JoppeJoppinger/Inkterface_GabeEdition/design/breakout-board.png

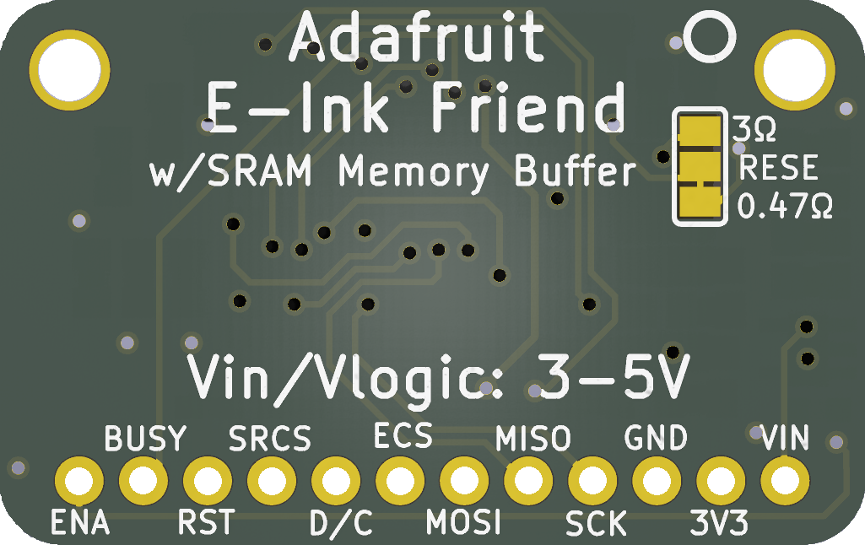
design/breakout-board.png
