JoppeJoppinger/Inkterface_GabeEdition/design/feather-board.png

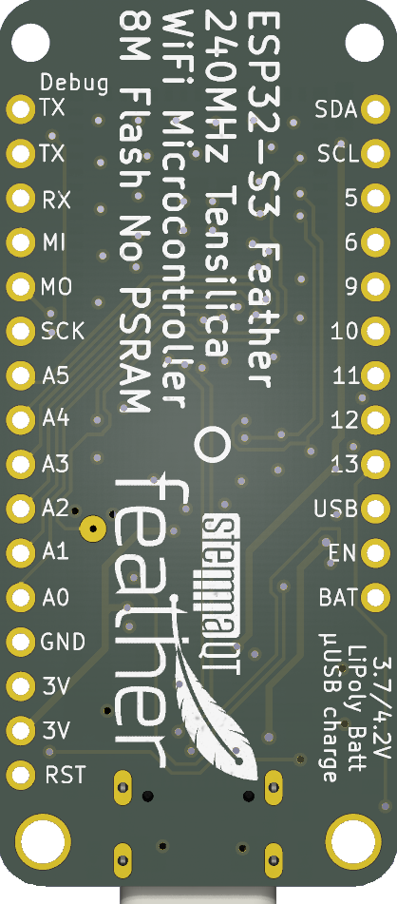
design/feather-board.png
