JoppeJoppinger/Inkterface_GabeEdition/design/store-assets/Header_Capsule.png

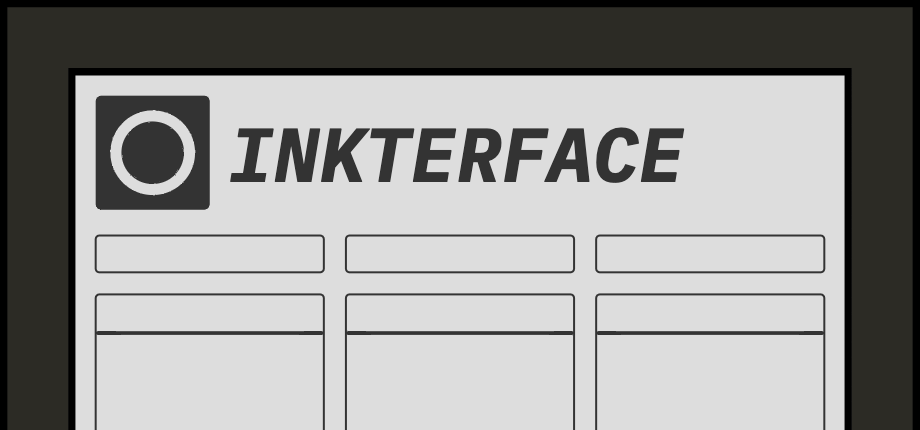
design/store-assets/Header_Capsule.png
