JoppeJoppinger/Inkterface_GabeEdition/design/store-assets/Library_Capsule.png

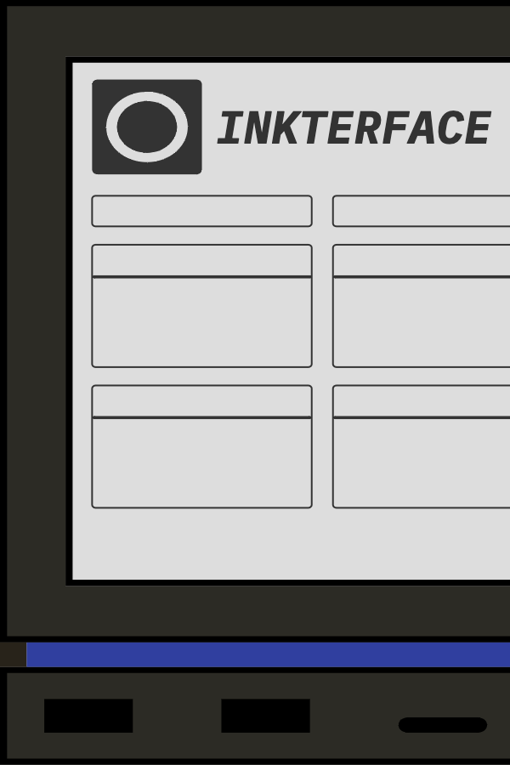
design/store-assets/Library_Capsule.png
