JoppeJoppinger/Inkterface_GabeEdition/design/store-assets/Library_Header.png

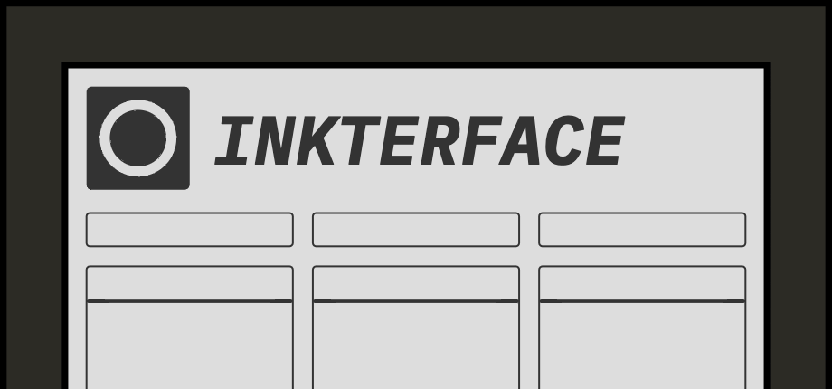
design/store-assets/Library_Header.png
