JoppeJoppinger/Inkterface_GabeEdition/design/store-assets/Library_Hero.png

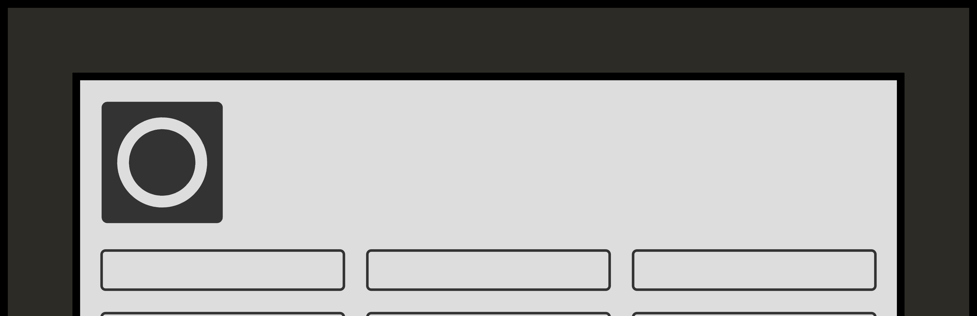
design/store-assets/Library_Hero.png
