JoppeJoppinger/Inkterface_GabeEdition/design/store-assets/Machine_Status.png

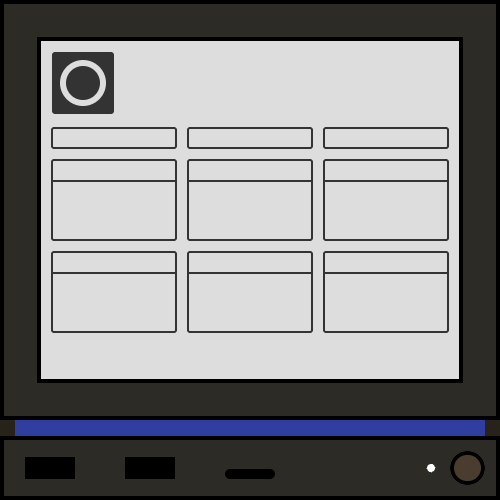
design/store-assets/Machine_Status.png
