JoppeJoppinger/Inkterface_GabeEdition/design/store-assets/Main_Capsule.png

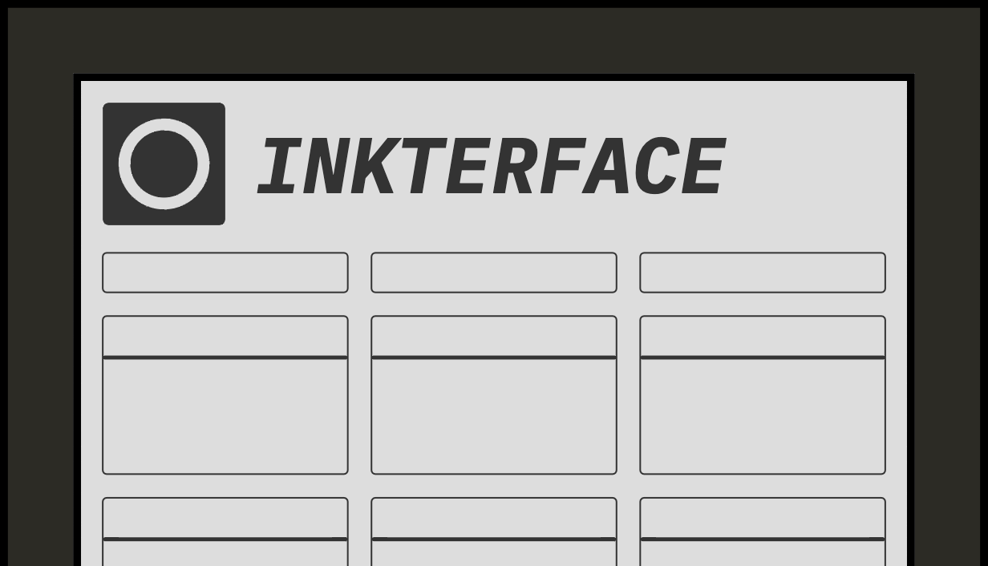
design/store-assets/Main_Capsule.png
