JoppeJoppinger/Inkterface_GabeEdition/design/store-assets/Small_Capsule.png

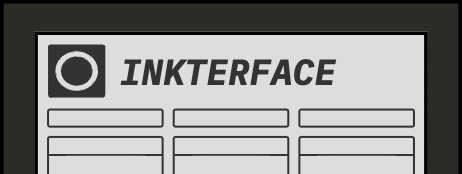
design/store-assets/Small_Capsule.png
