JoppeJoppinger/Inkterface_GabeEdition/docs/eInk Feather Friend Schematic.png

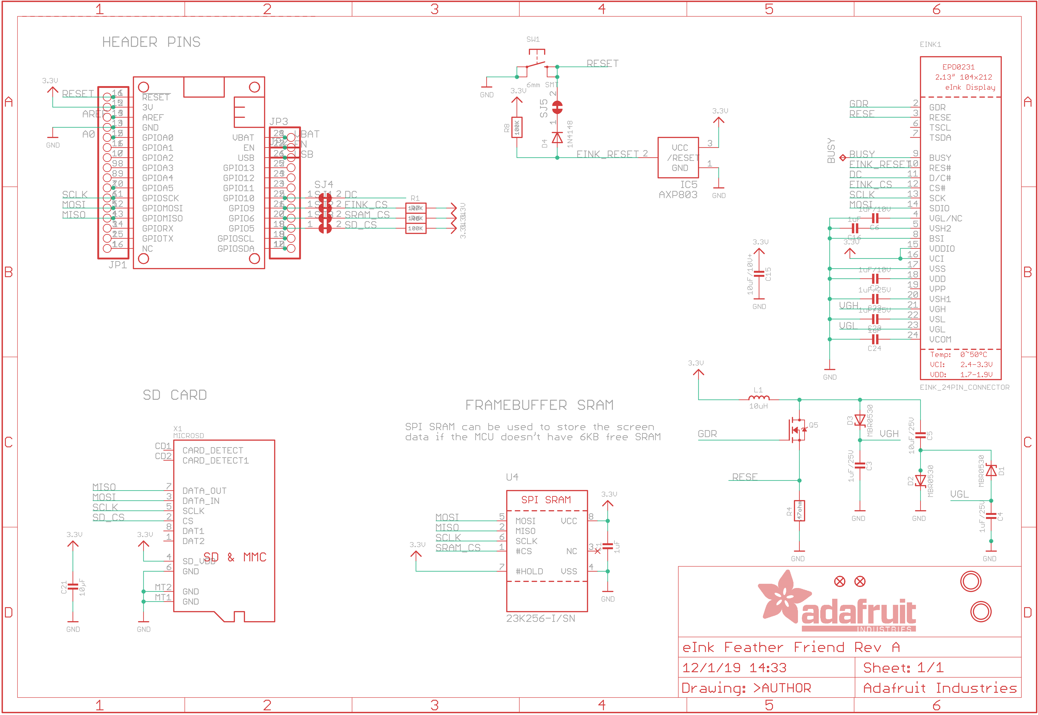
docs/eInk Feather Friend Schematic.png
