JoppeJoppinger/Inkterface_GabeEdition/resources/gabe_cube_original.png

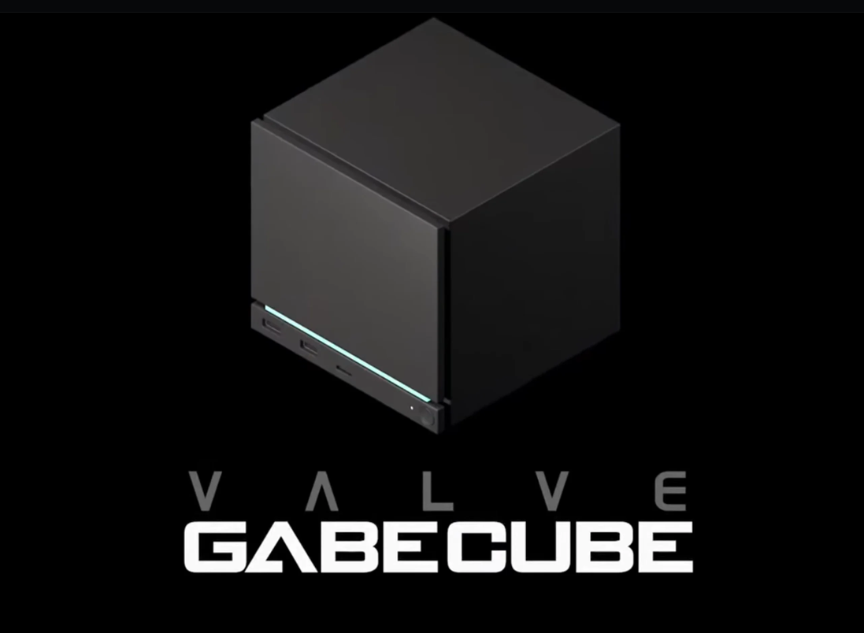
resources/gabe_cube_original.png
