JoppeJoppinger/Inkterface_GabeEdition/resources/gaben.png

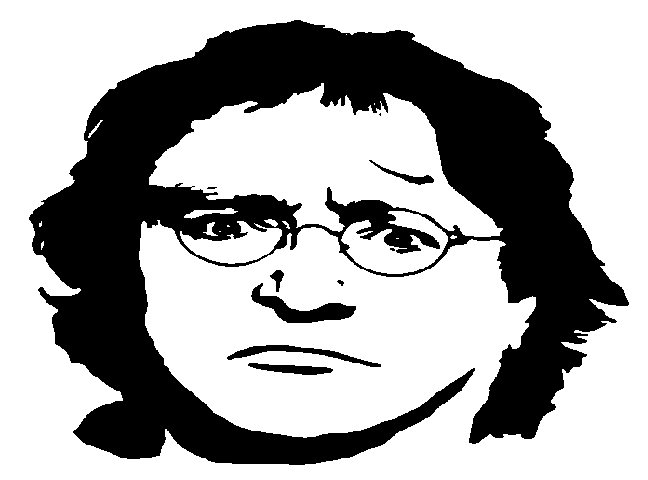
resources/gaben.png
