JoppeJoppinger/Inkterface_GabeEdition/cad/Inkterface - Print Plate.step

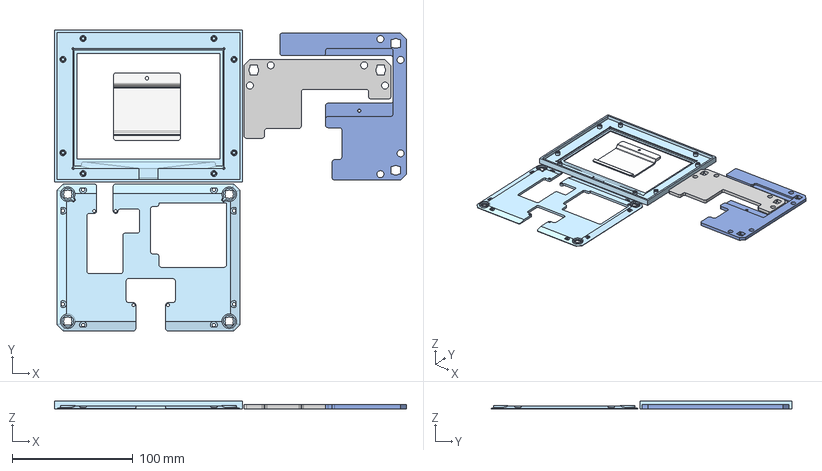
[picture p23: CAD file, 2026-10-14]
cad/Inkterface - Print Plate.step
292.1 x 249.6 x 6.50 mm
Faceplate
Battery Retainer
Board Plate
Midplate Left
Midplate Right
