JoppeJoppinger/Inkterface_GabeEdition/cad/Inkterface - Board Plate.step

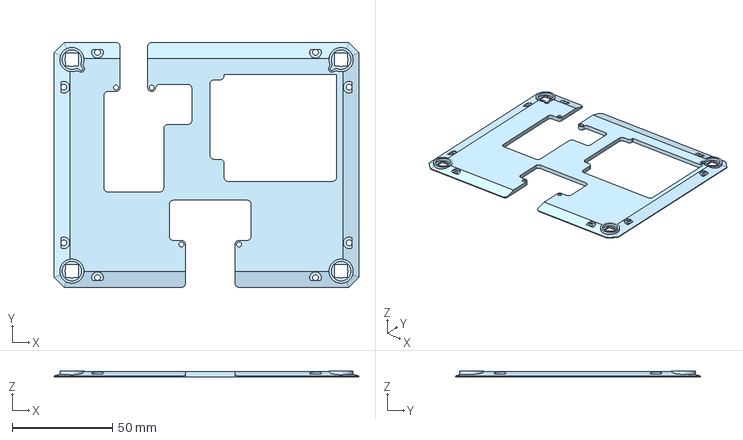
[picture p24: CAD file, 2026-10-14]
cad/Inkterface - Board Plate.step
151.8 x 121.9 x 2.81 mm
