JoppeJoppinger/Inkterface_GabeEdition/cad/Inkterface - Midplate Left.step

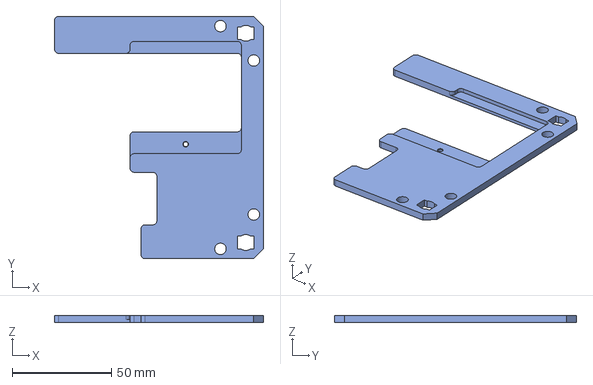
[picture p25: CAD file, 2026-10-14]
cad/Inkterface - Midplate Left.step
105.2 x 121.9 x 3.56 mm
