JoppeJoppinger/Inkterface_GabeEdition/cad/Inkterface - Midplate Right.step

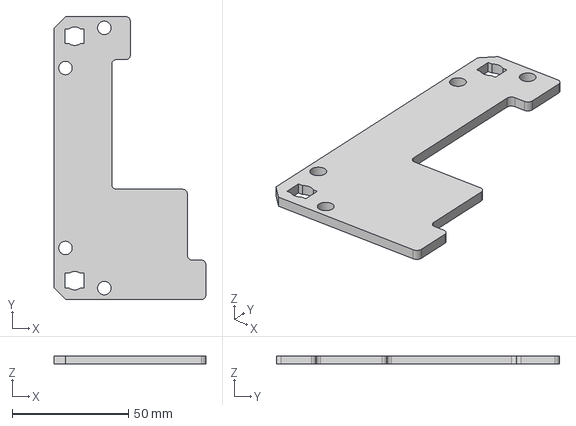
[picture p26: CAD file, 2026-10-14]
cad/Inkterface - Midplate Right.step
65.4 x 121.9 x 3.56 mm
