JoppeJoppinger/Inkterface_GabeEdition/cad/Inkterface - Faceplate.step

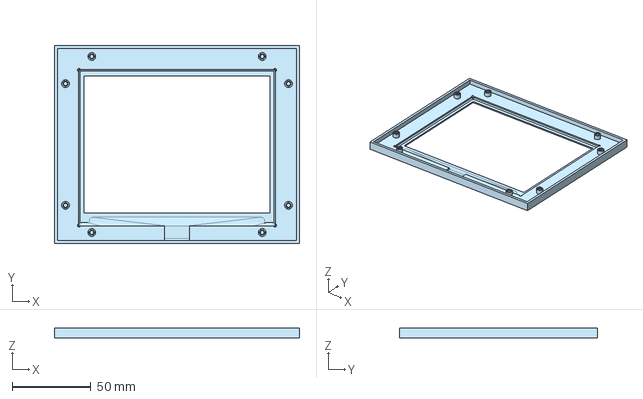
[picture p27: CAD file, 2026-10-14]
cad/Inkterface - Faceplate.step
156.0 x 126.1 x 6.50 mm
