JoppeJoppinger/Inkterface_GabeEdition/cad/Inkterface - Battery Retainer.step

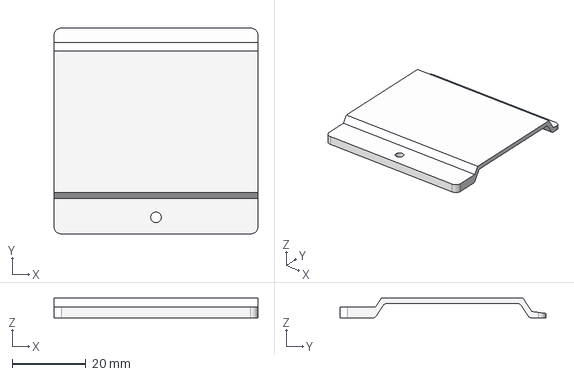
[picture p28: CAD file, 2026-10-14]
cad/Inkterface - Battery Retainer.step
55.5 x 56.0 x 5.44 mm
