JoppeJoppinger/Inkterface_GabeEdition/(list of files, cad)

Other CAD files:
cad/Inkterface - Battery Retainer.stl
cad/Inkterface - Board Plate.stl
cad/Inkterface - Faceplate.stl
cad/Inkterface - Midplate Left.stl
cad/Inkterface - Midplate Right.stl
cad/Inkterface - Print Plate.stl
