JoppeJoppinger/Inkterface_GabeEdition/docs/Inkterface Setup.pdf

### Inkterface Setup

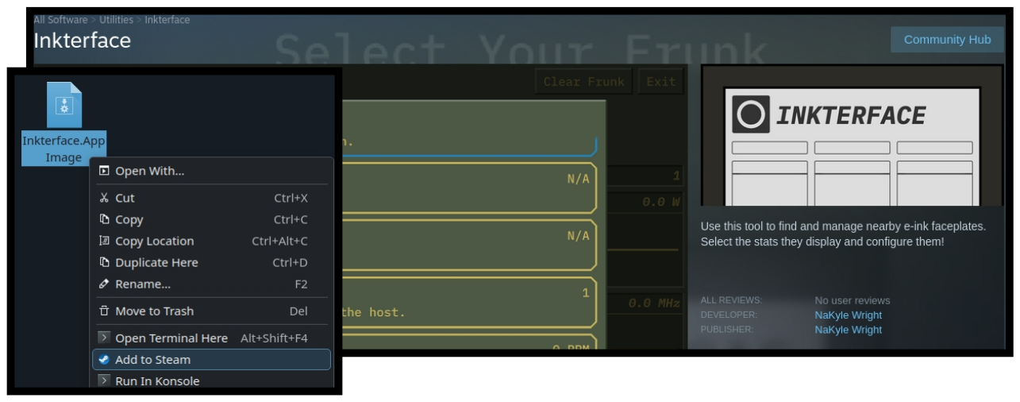
[picture p39: figure]

Install Application:
You can add the AppImage to Steam or install it once it's available on the store!

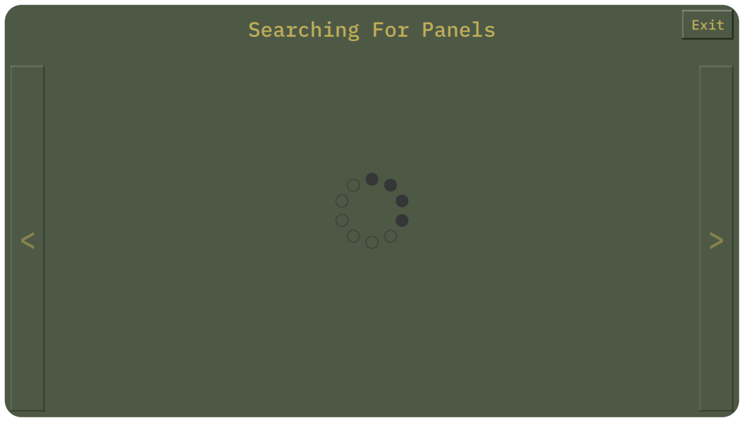
[picture p40: figure]

Discover Nearby Panels:
Make sure you have bluetooth enabled and that the panel is nearby.

If it doesn't appear try pressing the reset button on the back.

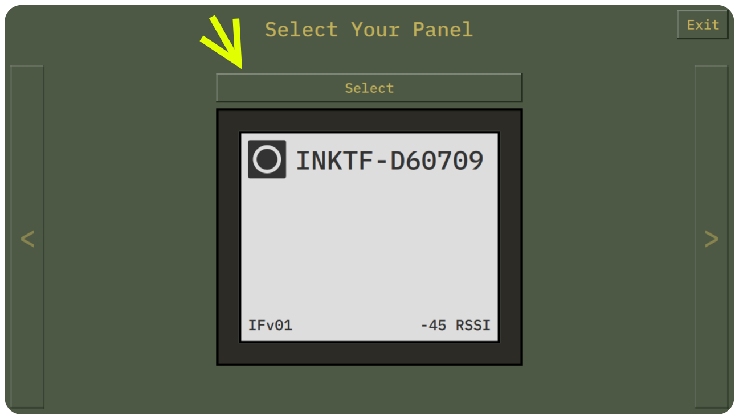
[picture p41: figure]

Select Your Panel:
Panels will show up on this as a list, sorted by RSSI, and with unsupported inkterfaceversions at the back.

Compare the name on your panel to the name shown on the result, then click Select.

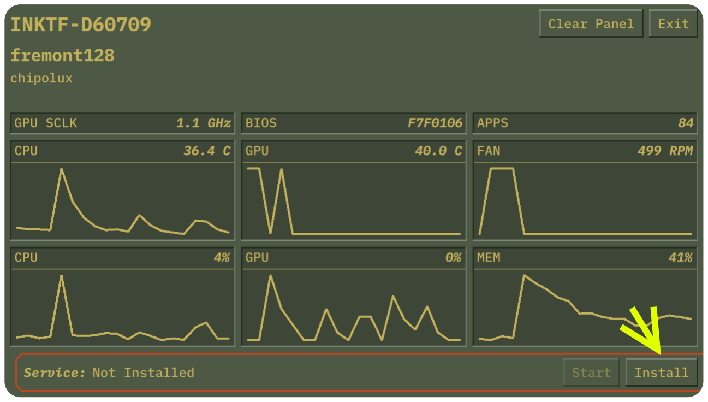
[picture p42: figure]

Install Service:
Once a panel is selected you will be taken to the configuration page.

Install the service that will run in the background to collect stats and transmit them to the Inkterface.

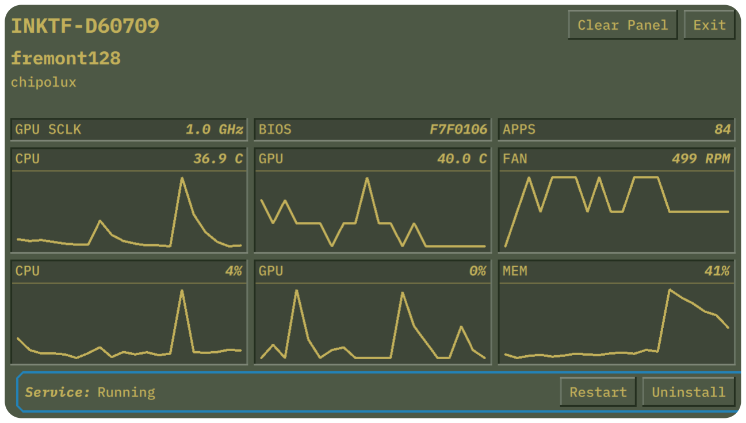
[picture p43: figure]

Configure What Inkterface Shows:
By clicking on any of the readouts you can adjust what is shown.

Changes take place on the next update cycle.

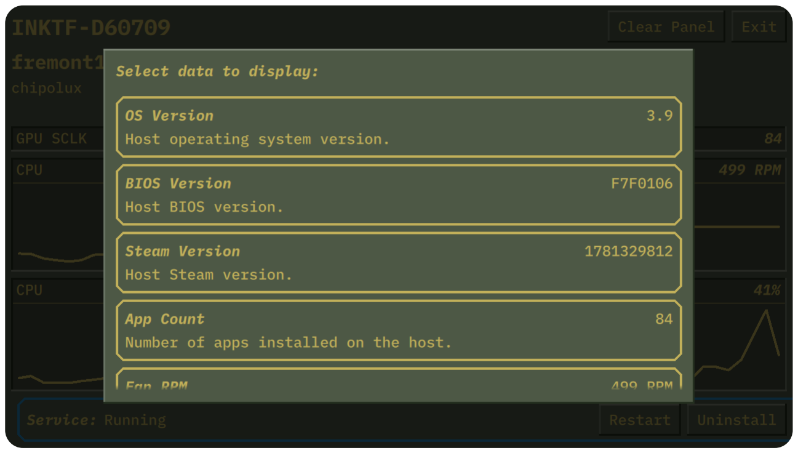
[picture p44: figure]

You're done! You can close the app, the service will maintain the connection automatically.

If you have issues try re-installing Inkterface, re-installing the service, and resetting your Inkterface!
