JoppeJoppinger/Inkterface_GabeEdition/boards/Adafruit eInk Feather Friend/Adafruit eInk Feather Friend.kicad_pcb

## KiCad design boards/Adafruit eInk Feather Friend/Adafruit eInk Feather Friend.kicad_pcb (2026-10-14)

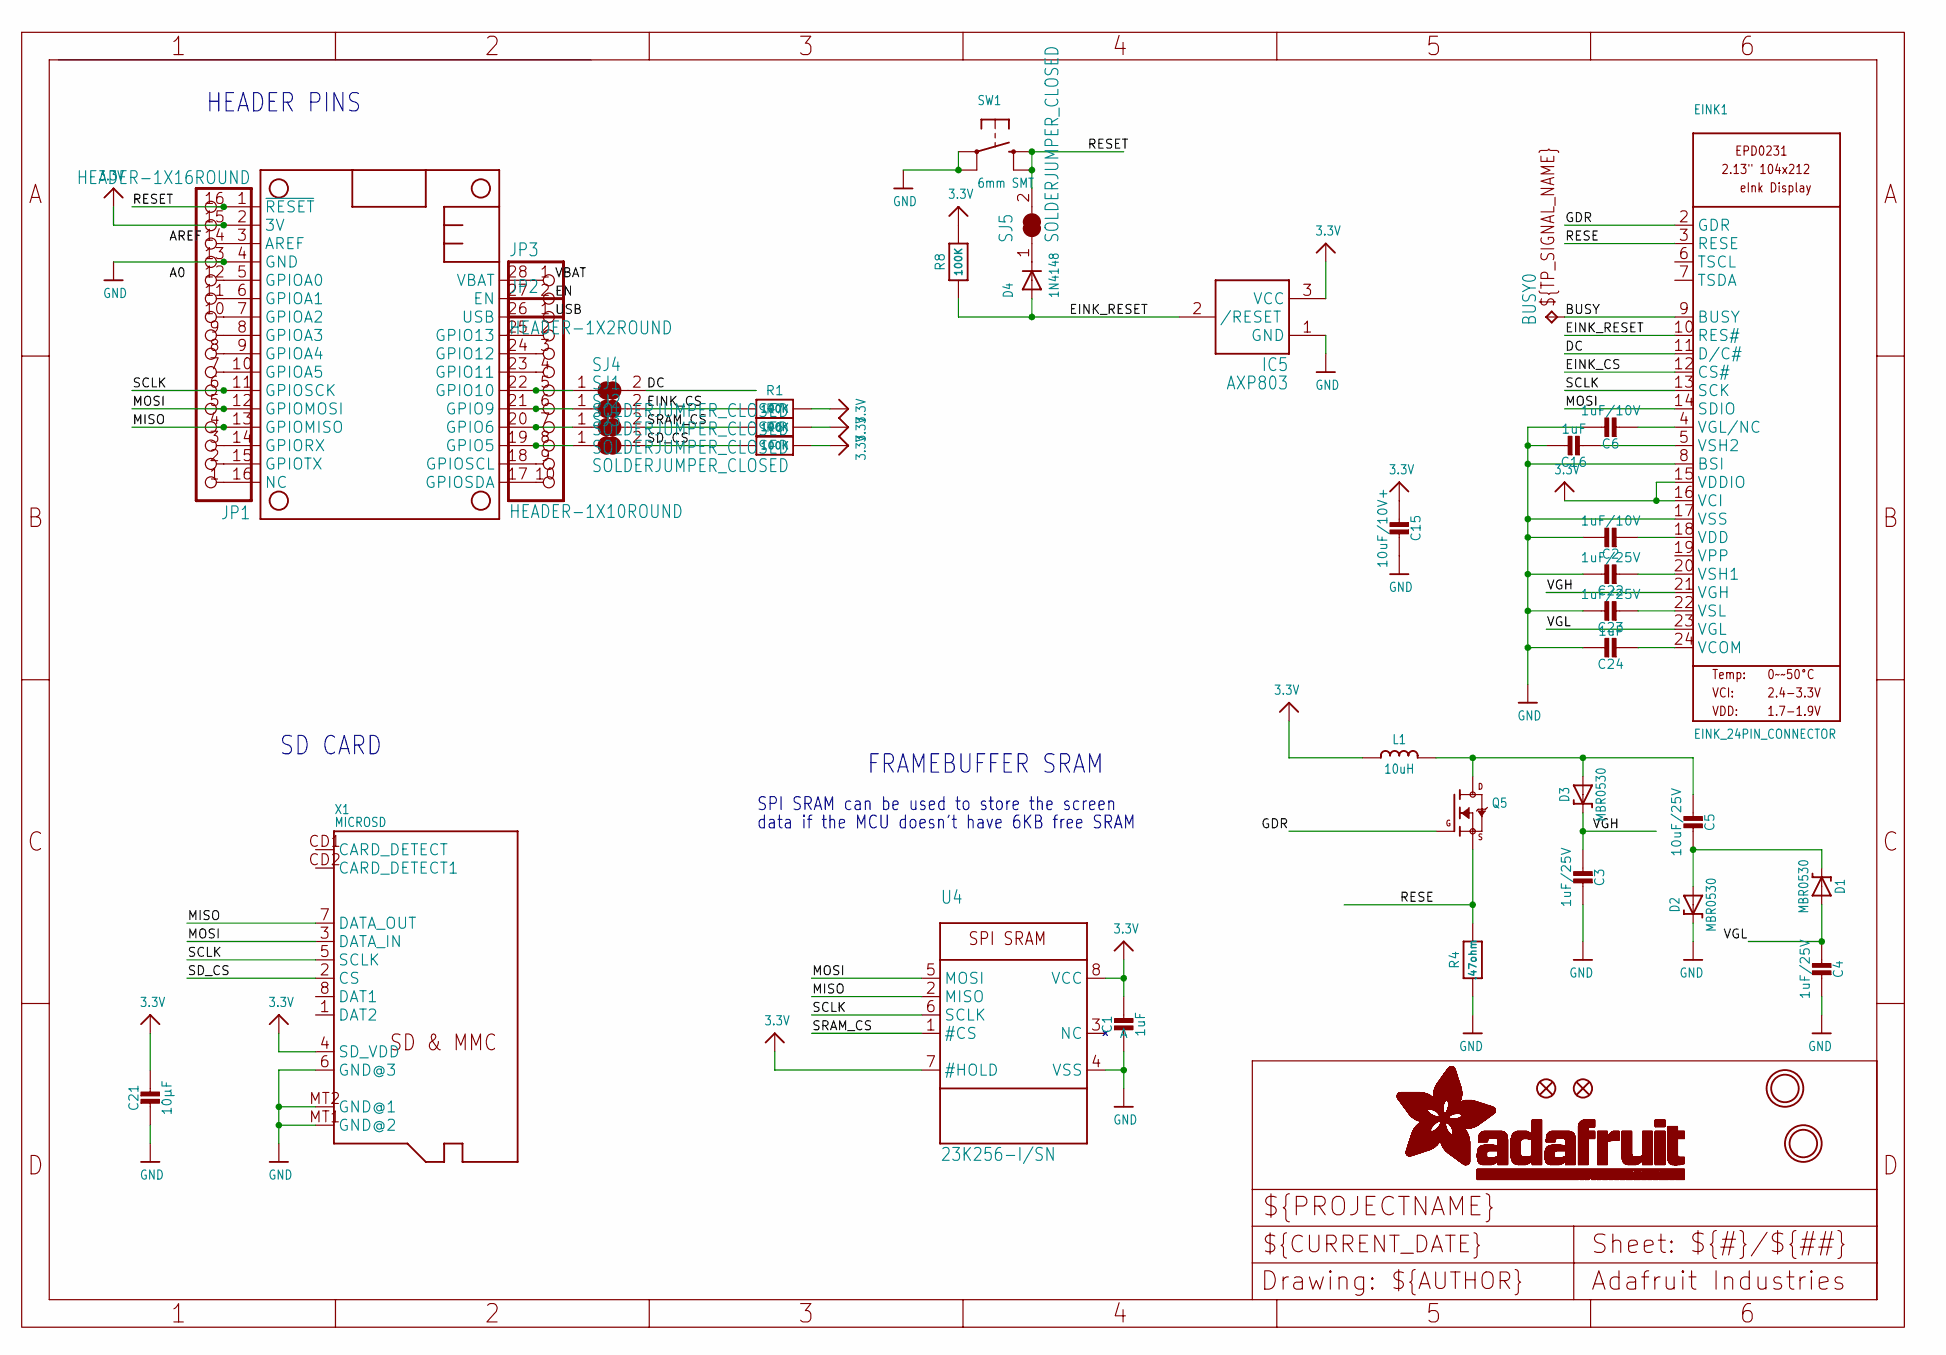
[picture p53: schematic Adafruit eInk Feather Friend.kicad_sch]

Parts:
BUSY0: TPTP15SQ; TP15SQ
C1: 1uF; 0805_10MGAP
C2, C6: 1uF/10V; 0805-NO
C3, C4, C22, C23: 1uF/25V; 0805-NO
C5: 10uF/25V; 0805-NO
C15: 10uF/10V+; 0805-NO
C16, C24: 1uF; 0805-NO
C21: 10µF; 0805-NO
D1, D2, D3: MBR0530; SOD-123
D4: 1N4148; SOD-323F
EINK1: EINK_24PIN_CONNECTOR; EINK_24PIN
FID1, FID3: FIDUCIAL_1MM
IC5: AXP803; SOT23
JP1: HEADER-1X16ROUND; 1X16_ROUND
JP2: HEADER-1X10ROUND; 1X10_ROUND
JP3: HEADER-1X2ROUND; 1X02_ROUND
L1: 10uH; INDUCTOR_4X4MM_NR401
MS1: FEATHERWING_NOHOLES
Q5: IRLML0100; SOT23-3
R1, R6, R7, R8: 100K; 0603-NO
R4: .47ohm; 0805_10MGAP
SJ1, SJ2, SJ3, SJ4, SJ5: SOLDERJUMPER_CLOSED; SOLDERJUMPER_CLOSEDWIRE
SW1: 6mm SMT; BTN_KMR2_4.6X2.8
U4: 23K256-I/SN; SOIC8_150MIL
U$3, U$4: MOUNTINGHOLE2.5; MOUNTINGHOLE_2.5_PLATED
X1: MICROSD

Connections:
3.3V: C1.1, C15.2, C21.1, EINK1.15 (VDDIO), EINK1.16 (VCI), IC5.3 (VCC), JP1.15, L1.P$2 (2), MS1.2 (3V), R1.2, R6.2, R7.2, R8.2, U4.7 (#HOLD), U4.8 (VCC), X1.4 (SD_VDD)
A0: JP1.12, MS1.5 (GPIOA0)
AREF: JP1.14, MS1.3 (AREF)
BUSY: BUSY0.TP, EINK1.9 (BUSY)
DC: EINK1.11 (D/C#), SJ4.2
EINK_CS: EINK1.12 (CS#), R1.1, SJ1.2
EINK_RESET: D4.A, EINK1.10 (RES#), IC5.2 (/RESET), R8.1
EN: JP3.2, MS1.27 (EN)
GDR: EINK1.2 (GDR), Q5.1 (G)
GND: C1.2, C2.1, C3.2, C4.2, C6.1, C15.1, C16.1, C21.2, C22.1, C23.1, C24.1, D2.C, EINK1.8 (BSI), EINK1.17 (VSS), IC5.1 (GND), JP1.13, MS1.4 (GND), R4.2, SW1.A, SW1.A' (P1), U4.4 (VSS), X1.6 (GND@3), X1.MT1 (GND@2), X1.MT2 (GND@1)
H: JP2.8, MS1.19 (GPIO5), SJ3.1
I: JP2.7, MS1.20 (GPIO6), SJ2.1
J: JP2.6, MS1.21 (GPIO9), SJ1.1
K: JP2.5, MS1.22 (GPIO10), SJ4.1
MISO: JP1.4, MS1.13 (GPIOMISO), U4.2 (MISO), X1.7 (DATA_OUT)
MOSI: EINK1.14 (SDIO), JP1.5, MS1.12 (GPIOMOSI), U4.5 (MOSI), X1.3 (DATA_IN)
unnamed: JP1.7, MS1.10 (GPIOA5)
unnamed: C5.2, D1.C, D2.A
unnamed: C5.1, D3.A, L1.P$1 (1), Q5.3 (D)
unnamed: C16.2, EINK1.5 (VSH2)
unnamed: C2.2, EINK1.18 (VDD)
unnamed: C22.2, EINK1.20 (VSH1)
unnamed: D4.C, SJ5.1
unnamed: JP1.11, MS1.6 (GPIOA1)
unnamed: C6.2, EINK1.4 (VGL/NC)
unnamed: JP1.10, MS1.7 (GPIOA2)
unnamed: JP1.9, MS1.8 (GPIOA3)
unnamed: JP1.8, MS1.9 (GPIOA4)
unnamed: JP1.3, MS1.14 (GPIORX)
unnamed: JP1.2, MS1.15 (GPIOTX)
unnamed: JP1.1, MS1.16 (NC)
unnamed: JP2.10, MS1.17 (GPIOSDA)
unnamed: JP2.9, MS1.18 (GPIOSCL)
unnamed: JP2.4, MS1.23 (GPIO11)
unnamed: JP2.3, MS1.24 (GPIO12)
unnamed: JP2.2, MS1.25 (GPIO13)
unnamed: C23.2, EINK1.22 (VSL)
unnamed: C24.2, EINK1.24 (VCOM)
RESE: EINK1.3 (RESE), Q5.2 (S), R4.1
RESET: JP1.16, MS1.1 (~RESET), SJ5.2, SW1.B (S), SW1.B' (S1)
SCLK: EINK1.13 (SCK), JP1.6, MS1.11 (GPIOSCK), U4.6 (SCLK), X1.5 (SCLK)
SD_CS: R6.1, SJ3.2, X1.2 (CS)
SRAM_CS: R7.1, SJ2.2, U4.1 (#CS)
USB: JP2.1, MS1.26 (USB)
VBAT: JP3.1, MS1.28 (VBAT)
VGH: C3.1, D3.C, EINK1.21 (VGH)
VGL: C4.1, D1.A, EINK1.23 (VGL)

Notes on the sheet:
FRAMEBUFFER SRAM
SPI SRAM can be used to store the screen
HEADER PINS
data if the MCU doesn't have 6KB free SRAM
SD CARD

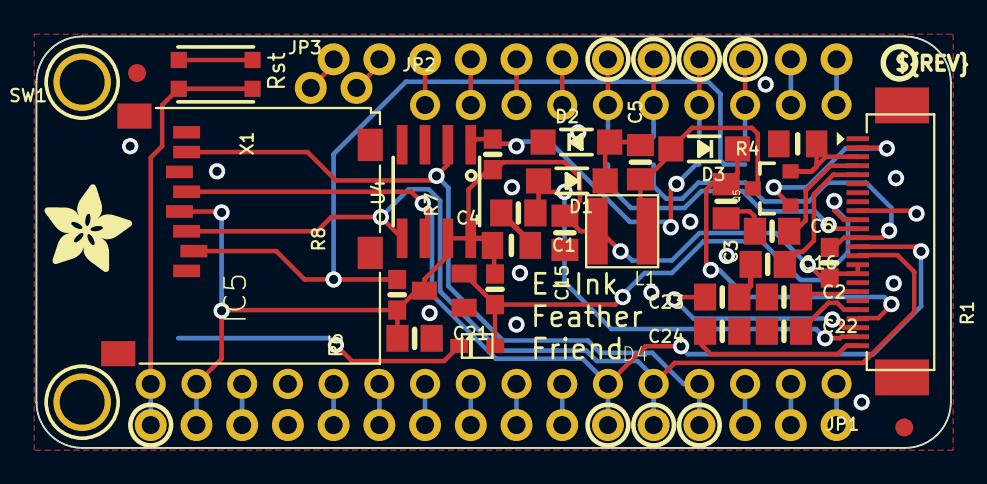
[picture p54: board Adafruit eInk Feather Friend.kicad_pcb from above]

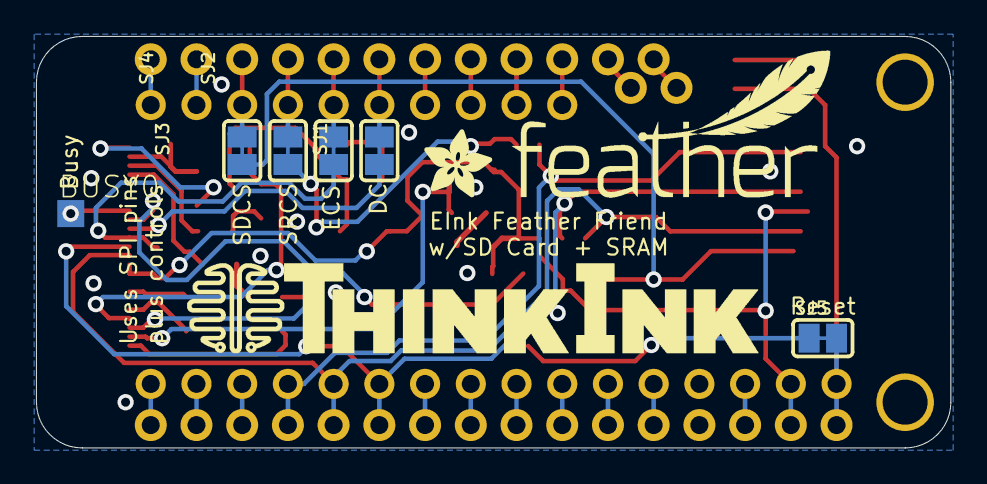
[picture p55: board Adafruit eInk Feather Friend.kicad_pcb from below]

Board: 2 copper layers, 50.8 x 22.9 mm, 47 parts (9 on the bottom side), 47 nets.

Other parts of the board:
U$5: THINKINK_1.25IN
U$6: FEATHERLOGO_MED
U$8: ADAFRUIT_5MM
U$9: PCBFEAT-REV-040
U$17: ADAFRUIT_3.5MM
