JoppeJoppinger/Inkterface_GabeEdition/boards/originals/Adafruit eInk Breakout Friend.brd

## EAGLE design boards/originals/Adafruit eInk Breakout Friend.brd (2026-10-14)

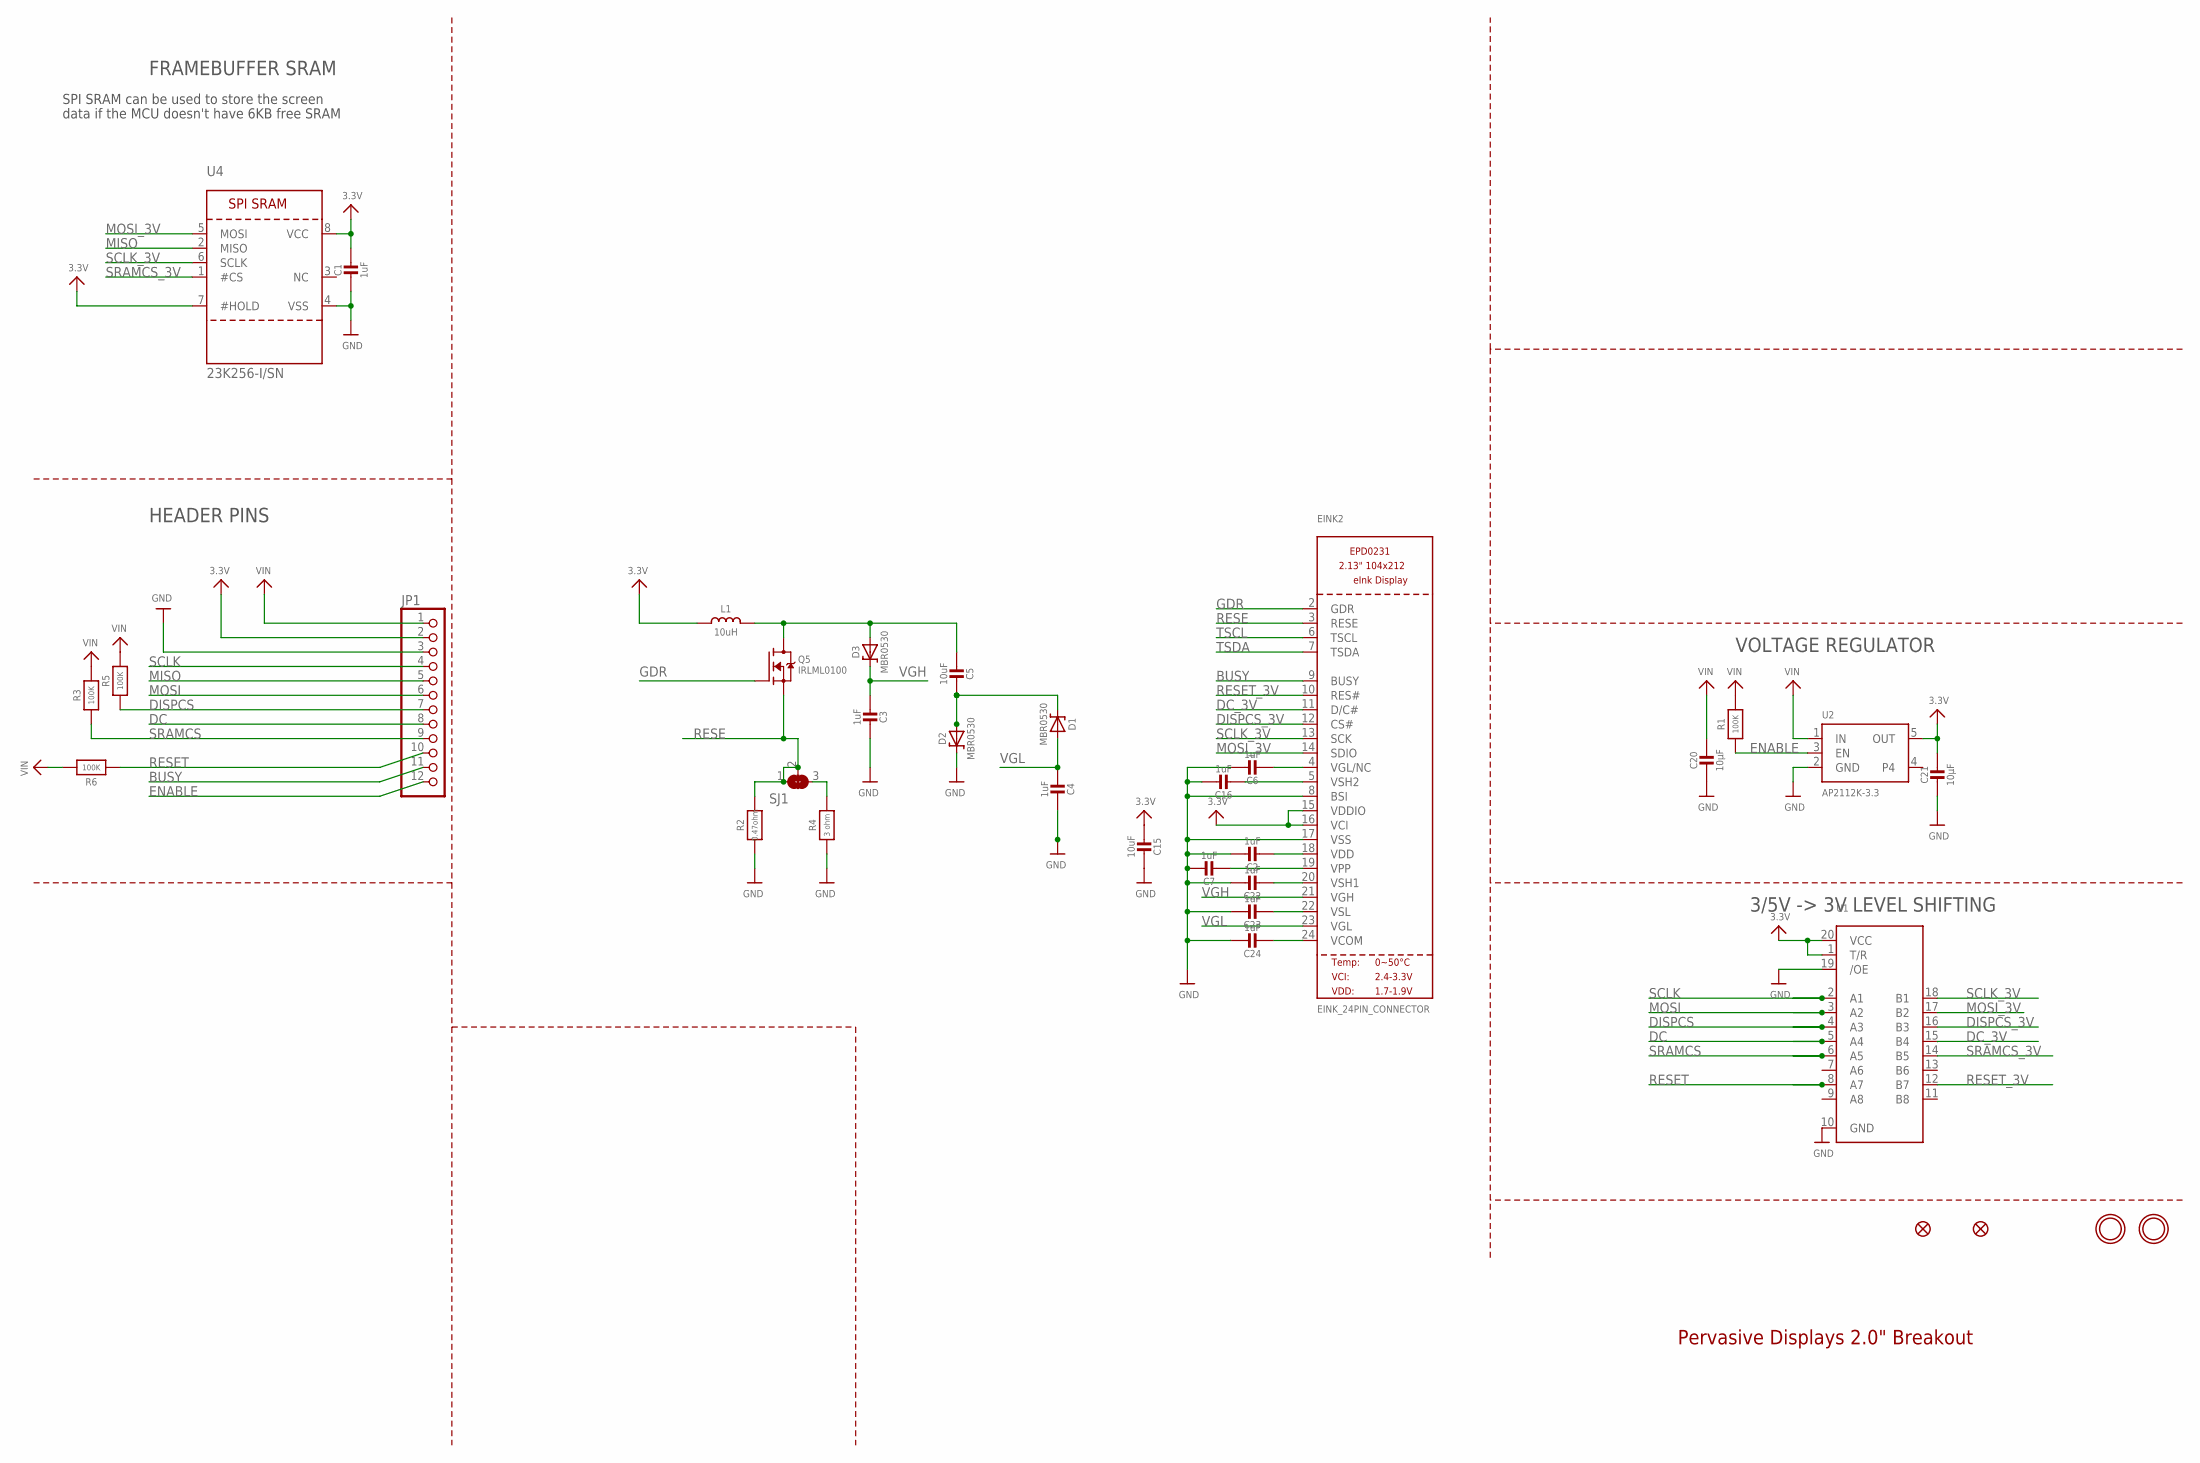
[picture p59: schematic Adafruit eInk Breakout Friend.sch]

Parts:
C1: 1uF; 0805_10MGAP
C2, C3, C4, C6, C7, C16, C22, C23, C24: 1uF; 0805-NO
C5, C15: 10uF; 0805-NO
C20, C21: 10µF; 0805-NO
D1, D2, D3: MBR0530; SOD-123
EINK2: EINK_24PIN_CONNECTOR; EINK_24PIN
FID2, FID3: FIDUCIAL_1MM
JP1: HEADER-1X1276MIL; 1X12_ROUND_76MIL
L1: 10uH; INDUCTOR_4X4MM_NR401
Q5: IRLML0100; SOT23-3
R1, R3, R5, R6: 100K; 0603-NO
R2: 0.47ohm; 0805-NO
R4: 3 ohm; 0805-NO
SJ1: SOLDERJUMPER_2WAY; SOLDERJUMPER_2WAY_OPEN_NOPASTE
U1: 74LCX245; TSSOP20
U2: AP2112K-3.3; SOT23-5
U4: 23K256-I/SN; SOIC8_150MIL
U$3, U$4: MOUNTINGHOLE2.5; MOUNTINGHOLE_2.5_PLATED

Connections:
3.3V: C1.1, C15.2, C21.1, EINK2.15 (VDDIO), EINK2.16 (VCI), JP1.2, L1.P$2 (2), U1.1 (T/R), U1.20 (VCC), U2.5 (OUT), U4.7 (#HOLD), U4.8 (VCC)
BUSY: EINK2.9 (BUSY), JP1.11
DC: JP1.8, U1.5 (A4)
DC_3V: EINK2.11 (D/C#), U1.15 (B4)
DISPCS: JP1.7, R5.1, U1.4 (A3)
DISPCS_3V: EINK2.12 (CS#), U1.16 (B3)
ENABLE: JP1.12, R1.1, U2.3 (EN)
GDR: EINK2.2 (GDR), Q5.1 (G)
GND: C1.2, C2.1, C3.2, C4.2, C6.1, C7.1, C15.1, C16.1, C20.2, C21.2, C22.1, C23.1, C24.1, D2.C, EINK2.8 (BSI), EINK2.17 (VSS), JP1.3, R2.2, R4.2, U1.10 (GND), U1.19 (/OE), U2.2 (GND), U4.4 (VSS)
MISO: JP1.5, U4.2 (MISO)
MOSI: JP1.6, U1.3 (A2)
MOSI_3V: EINK2.14 (SDIO), U1.17 (B2), U4.5 (MOSI)
unnamed: C7.2, EINK2.19 (VPP)
unnamed: C5.2, D1.C, D2.A
unnamed: C5.1, D3.A, L1.P$1 (1), Q5.3 (D)
unnamed: C16.2, EINK2.5 (VSH2)
unnamed: C2.2, EINK2.18 (VDD)
unnamed: C22.2, EINK2.20 (VSH1)
unnamed: R4.1, SJ1.3
unnamed: C6.2, EINK2.4 (VGL/NC)
unnamed: C23.2, EINK2.22 (VSL)
unnamed: C24.2, EINK2.24 (VCOM)
RESE: EINK2.3 (RESE), Q5.2 (S), R2.1, SJ1.1, SJ1.2
RESET: JP1.10, R6.1, U1.8 (A7)
RESET_3V: EINK2.10 (RES#), U1.12 (B7)
SCLK: JP1.4, U1.2 (A1)
SCLK_3V: EINK2.13 (SCK), U1.18 (B1), U4.6 (SCLK)
SRAMCS: JP1.9, R3.1, U1.6 (A5)
SRAMCS_3V: U1.14 (B5), U4.1 (#CS)
TSCL: EINK2.6 (TSCL)
TSDA: EINK2.7 (TSDA)
VGH: C3.1, D3.C, EINK2.21 (VGH)
VGL: C4.1, D1.A, EINK2.23 (VGL)
VIN: C20.1, JP1.1, R1.2, R3.2, R5.2, R6.2, U2.1 (IN)

Notes on the sheet:
Pervasive Displays 2.0" Breakout
VOLTAGE REGULATOR
3/5V -> 3V LEVEL SHIFTING
HEADER PINS
FRAMEBUFFER SRAM
SPI SRAM can be used to store the screen
data if the MCU doesn't have 6KB free SRAM

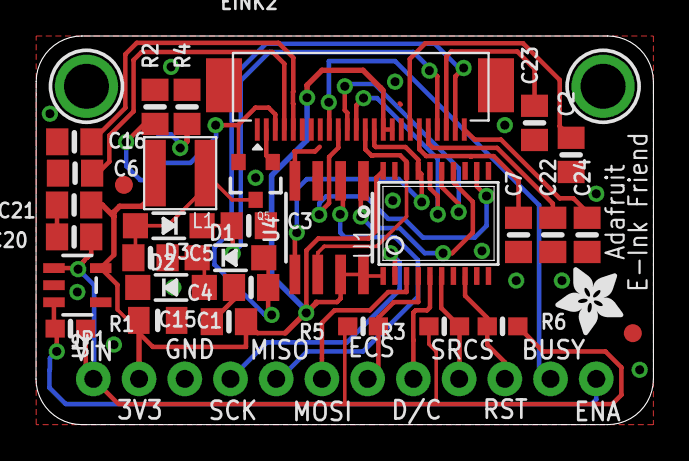
[picture p60: board Adafruit eInk Breakout Friend.brd from above]

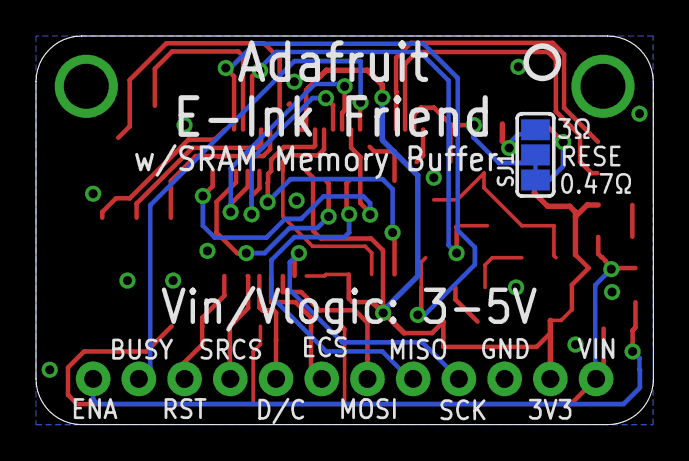
[picture p61: board Adafruit eInk Breakout Friend.brd from below]

Board: 2 copper layers, 34.3 x 21.6 mm, 37 parts (2 on the bottom side), 32 nets.

Other parts of the board:
U$2: ADAFRUIT_3.5MM
U$9: PCBFEAT-REV-040
