JoppeJoppinger/Inkterface_GabeEdition/boards/originals/Adafruit ESP32 Feather V2.brd

## EAGLE design boards/originals/Adafruit ESP32 Feather V2.brd (2026-10-14)

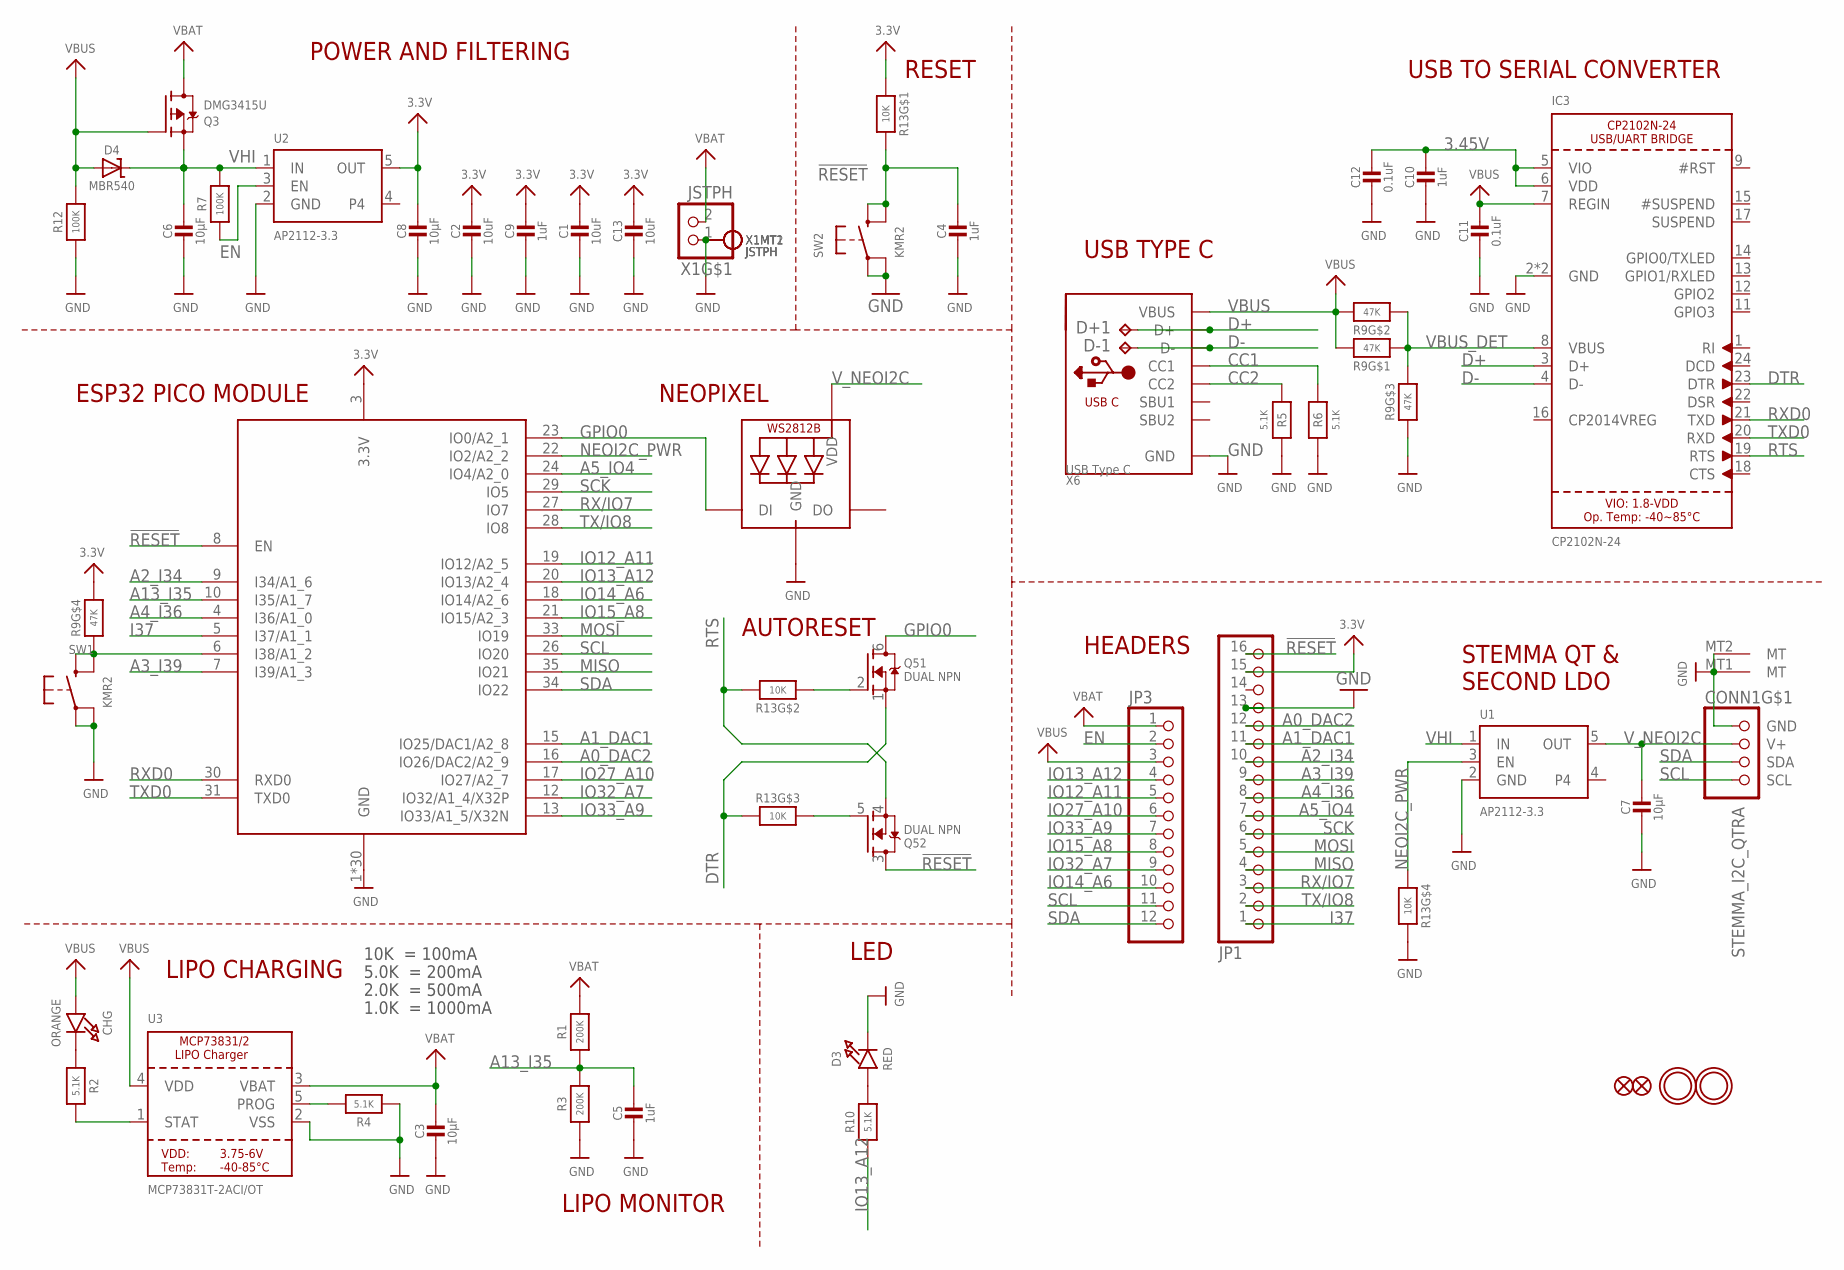
[picture p62: schematic Adafruit ESP32 Feather V2.sch]

Parts:
C1, C2, C13: 10uF; 0805-NO
C3, C6, C7, C8: 10µF; 0805-NO
C4, C5, C9, C10: 1uF; 0603-NO
C11, C12: 0.1uF; 0603-NO
CHG: ORANGE; CHIPLED_0603_NOOUTLINE
CONN1: STEMMA_I2C_QTRA; JST_SH4_RA
D3: RED; CHIPLED_0603_NOOUTLINE
D4: MBR540; SOD-123
D+1: TPB1,27; B1,27
D-1: TPB1,27; B1,27
IC3: CP2102N-24; QFN24_4MM_SMSC
JP1: HEADER-1X16ROUND; 1X16_ROUND
JP3: HEADER-1X12; 1X12_ROUND
LED1: WS2812B3535; LED3535
Q3: DMG3415U; SOT23-R
Q5: DUAL NPN; SOT363
R1, R3: 200K; 0603-NO
R2, R4, R5, R6, R10: 5.1K; 0603-NO
R7, R12: 100K; 0603-NO
R9: 47K; RESPACK_4X0603
R13: 10K; RESPACK_4X0603
SW1, SW2: KMR2; BTN_KMR2_4.6X2.8
U1, U2: AP2112-3.3; SOT23-5
U3: MCP73831T-2ACI/OT; SOT23-5
U$31, U$32: MOUNTINGHOLE2.5; MOUNTINGHOLE_2.5_PLATED
U$34, U$35: FIDUCIAL_1MM
X1: JSTPH; JSTPH2_BATT
X3: ESP32-PICO-MINI-02MINI; ESP32-PICO-MINI
X6: USB Type C; USB_C_CUSB31-CFM2AX-01-X

Connections:
3.3V: C1.1, C2.1, C8.1, C9.1, C13.1, JP1.15, R9.5 (2), R13.1, U2.5 (OUT), X3.3 (3.3V)
3.45V: C10.1, C12.1, IC3.5 (VIO), IC3.6 (VDD)
!RESET: C4.1, JP1.16, Q5.3 (D), R13.8 (2), SW2.B (S), SW2.B' (S1), X3.8 (EN)
A0_DAC2: JP1.12, X3.16 (IO26/DAC2/A2_9)
A1_DAC1: JP1.11, X3.15 (IO25/DAC1/A2_8)
A2_I34: JP1.10, X3.9 (I34/A1_6)
A3_I39: JP1.9, X3.7 (I39/A1_3)
A4_I36: JP1.8, X3.4 (I36/A1_0)
A5_IO4: JP1.7, X3.24 (IO4/A2_0)
A13_I35: C5.1, R1.1, R3.2, X3.10 (I35/A1_7)
CC1: R6.2, X6.A5 (CC1)
CC2: R5.2, X6.B5 (CC2)
D+: D+1.TP, IC3.3 (D+), X6.A6 (D+), X6.B6 (D+)
D-: D-1.TP, IC3.4 (D-), X6.A7 (D-), X6.B7 (D-)
DTR: IC3.23 (DTR), Q5.1 (S), R13.3 (1)
EN: JP3.2, R7.1, U2.3 (EN)
GND: C1.2, C2.2, C3.2, C4.2, C5.2, C6.2, C7.2, C8.2, C9.2, C10.2, C11.2, C12.2, C13.2, CONN1.1 (GND), CONN1.MT1 (MT), CONN1.MT2 (MT), D3.C, IC3.2 (GND), IC3.THERM (GND), JP1.13, LED1.4 (GND), R3.1, R4.1, R5.1, R6.1, R9.3 (1), R12.1, R13.5 (2), SW1.A, SW1.A' (P1), SW2.A, SW2.A' (P1), U1.2 (GND), U2.2 (GND), U3.2 (VSS), X1.1, X1.NC1, X1.NC2, X3.1 (GND), X3.2 (GND), X3.11 (GND), X3.14 (GND), X3.36 (GND), X3.37 (GND), X3.38 (GND), X3.39 (GND), X3.40 (GND), X3.41 (GND), X3.42 (GND), X3.43 (GND), X3.44 (GND), X3.45 (GND), X3.46 (GND), X3.47 (GND), X3.48 (GND), X3.49 (GND), X3.50 (GND), X3.51 (GND), X3.52 (GND), X3.53 (GND), X3.54 (GND), X3.55 (GND), X3.56 (GND), X3.57 (GND), X3.58 (GND), X3.59 (GND), X3.60 (GND), X3.61 (GND), X6.A1B12 (GND), X6.B1A12 (GND)
GPIO0: LED1.1 (DI), Q5.6 (D), X3.23 (IO0/A2_1)
I37: JP1.1, X3.5 (I37/A1_1)
IO12_A11: JP3.5, X3.19 (IO12/A2_5)
IO13_A12: JP3.4, R10.1, X3.20 (IO13/A2_4)
IO14_A6: JP3.10, X3.18 (IO14/A2_6)
IO15_A8: JP3.8, X3.21 (IO15/A2_3)
IO27_A10: JP3.6, X3.17 (IO27/A2_7)
IO32_A7: JP3.9, X3.12 (IO32/A1_4/X32P)
IO33_A9: JP3.7, X3.13 (IO33/A1_5/X32N)
MISO: JP1.4, X3.35 (IO21)
MOSI: JP1.5, X3.33 (IO19)
unnamed: CHG.C, R2.1
unnamed: R2.2, U3.1 (STAT)
unnamed: R4.2, U3.5 (PROG)
unnamed: D3.A, R10.2
unnamed: R9.4 (1), SW1.B (S), SW1.B' (S1), X3.6 (I38/A1_2)
unnamed: Q5.5 (G), R13.6 (2)
unnamed: Q5.2 (G), R13.2 (1)
NEOI2C_PWR: R13.4 (1), U1.3 (EN), X3.22 (IO2/A2_2)
RTS: IC3.19 (RTS), Q5.4 (S), R13.7 (2)
RX/IO7: JP1.3, X3.27 (IO7)
RXD0: IC3.21 (TXD), X3.30 (RXD0)
SCK: JP1.6, X3.29 (IO5)
SCL: CONN1.4 (SCL), JP3.11, X3.26 (IO20)
SDA: CONN1.3 (SDA), JP3.12, X3.34 (IO22)
TX/IO8: JP1.2, X3.28 (IO8)
TXD0: IC3.20 (RXD), X3.31 (TXD0)
VBAT: C3.1, JP3.1, Q3.3 (D), R1.2, U3.3 (VBAT), X1.2
VBUS: C11.1, CHG.A, D4.A, IC3.7 (REGIN), JP3.3, Q3.1 (G), R9.7 (2), R9.8 (2), R12.2, U3.4 (VDD), X6.A4B9 (VBUS), X6.B4A9 (VBUS)
VBUS_DET: IC3.8 (VBUS), R9.1, R9.2 (1), R9.6 (2)
VHI: C6.1, D4.C, Q3.2 (S), R7.2, U1.1 (IN), U2.1 (IN)
V_NEOI2C: C7.1, CONN1.2 (V+), LED1.2 (VDD), U1.5 (OUT)

Notes on the sheet:
POWER AND FILTERING
RESET
10K = 100mA
5.0K = 200mA
2.0K = 500mA
1.0K = 1000mA
USB TO SERIAL CONVERTER
LIPO CHARGING
LED
ESP32 PICO MODULE
LIPO MONITOR
HEADERS
STEMMA QT & SECOND LDO
USB TYPE C
AUTORESET
NEOPIXEL

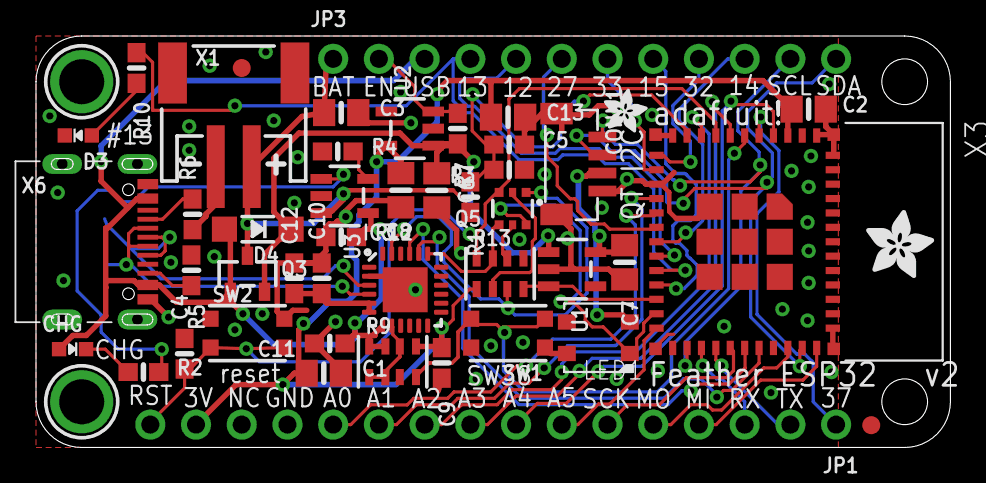
[picture p63: board Adafruit ESP32 Feather V2.brd from above]

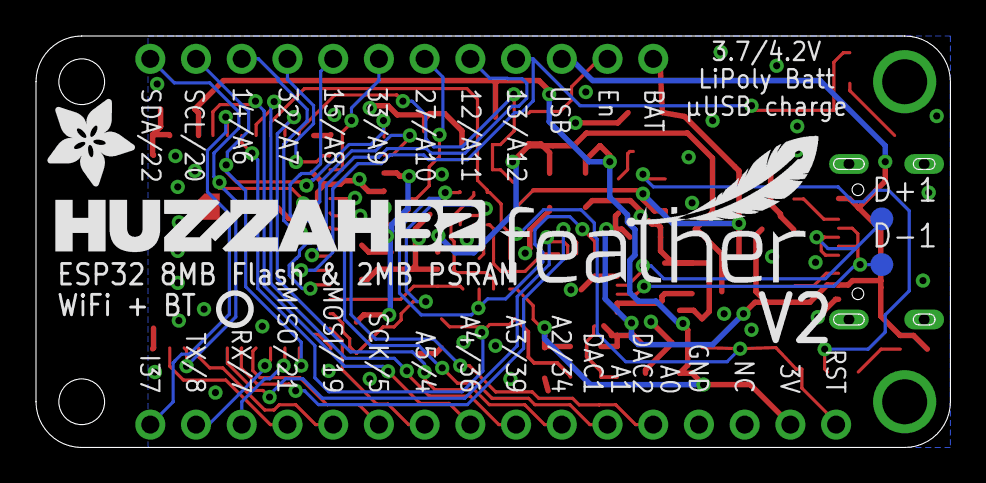
[picture p64: board Adafruit ESP32 Feather V2.brd from below]

Board: 2 copper layers, 50.8 x 22.9 mm, 54 parts (6 on the bottom side), 49 nets.

Other parts of the board:
U$7: ADAFRUIT_5MM
U$9: FEATHERLOGO_MED
U$13: PCBFEAT-REV-040
U$14: ADAFRUIT_2.5MM
U$15: ADAFRUIT_3.5MM
U$43: HUZZAH32
