JoppeJoppinger/Inkterface_GabeEdition/(commit log)

2026-10-14 Publish Inkterface Gabe Edition
    [Adafruit ESP32 Feather V2.brd, Adafruit ESP32 Feather V2.kicad_pcb, Adafruit ESP32 Feather V2.kicad_sch, Adafruit ESP32 Feather V2.sch, Adafruit ESP32-S3 8MB No PSRAM.brd, Adafruit ESP32-S3 8MB No PSRAM.kicad_pcb, Adafruit ESP32-S3 8MB No PSRAM.kicad_sch, Adafruit ESP32-S3 8MB No PSRAM.sch]
2026-10-26 Improve Feather idle battery life
    Use SW38 for deep-sleep wake, reduce CPU and peripheral power, and connect immediately when the selected panel is discovered.
